University-at-Buffalo-SEDS/Flight-Computer-PCB/orders/Digikey 2019-11-08.xlsx

Mfg | Mfg PN | Digikey PN | Description | Qty | Unit Price | Subtotal
STMicroelectronics | STM32F303RET6 | 497-15163-ND | ARM® Cortex®-M4 STM32F3 Microcontroller IC 32-Bit 72MHz 512KB (512K x 8) FLASH 64-LQFP (10x10) | 4 | $7.19 | $28.76
Diodes Incorporated | DMN3023L-7 | DMN3023L-7DICT-ND | N-Channel 30V 6.2A (Ta) 900mW (Ta) Surface Mount SOT-23 | 10 | $0.30 | $2.98
Diodes Incorporated | DMP3099L-7 | DMP3099L-7DICT-ND | P-Channel 30V 3.8A (Ta) 1.08W (Ta) Surface Mount SOT-23 | 10 | $0.25 | $2.50
ON Semiconductor | BSS138 | BSS138CT-ND | N-Channel 50V 220mA (Ta) 360mW (Ta) Surface Mount SOT-23-3 | 10 | $0.22 | $2.20
ON Semiconductor | BSS84 | BSS84CT-ND | P-Channel 50V 130mA (Ta) 360mW (Ta) Surface Mount SOT-23-3 | 10 | $0.28 | $2.80
Nexperia USA Inc. | BAT54S,215 | 1727-2904-1-ND | Diode Array 1 Pair Series Connection Schottky 30V 200mA (DC) Surface Mount TO-236-3, SC-59, SOT-23-3 | 20 | $0.20 | $3.96
Winbond Electronics | W25Q16JVSNIQ | W25Q16JVSNIQ-ND | FLASH - NOR Memory IC 16Mb (2M x 8) SPI - Quad I/O 133MHz 8-SOIC | 4 | $0.49 | $1.96
On Shore Technology Inc. | OSTVN08A150 | ED10566-ND | 8 Position Wire to Board Terminal Block Horizontal with Board 0.100" (2.54mm) Through Hole | 4 | $2.36 | $9.44
Samsung Electro-Mechanics | CL10B104KB8NNNC | 1276-1000-1-ND | 0.1µF ±10% 50V Ceramic Capacitor X7R 0603 (1608 Metric) | 100 | $0.01 | $1.18
Maxim Integrated | MAX7375AXR805+T | MAX7375AXR805+TCT-ND | 8MHz XO (Standard) CMOS Oscillator 2.7V ~ 5.5V SC-70, SOT-323 | 4 | $1.46 | $5.84
 |  |  |  |  | GT | $61.62
