University-at-Buffalo-SEDS/Flight-Computer-PCB/Flight Computer.kicad_pcb

## KiCad design Flight Computer.kicad_pcb (2020-02-22)

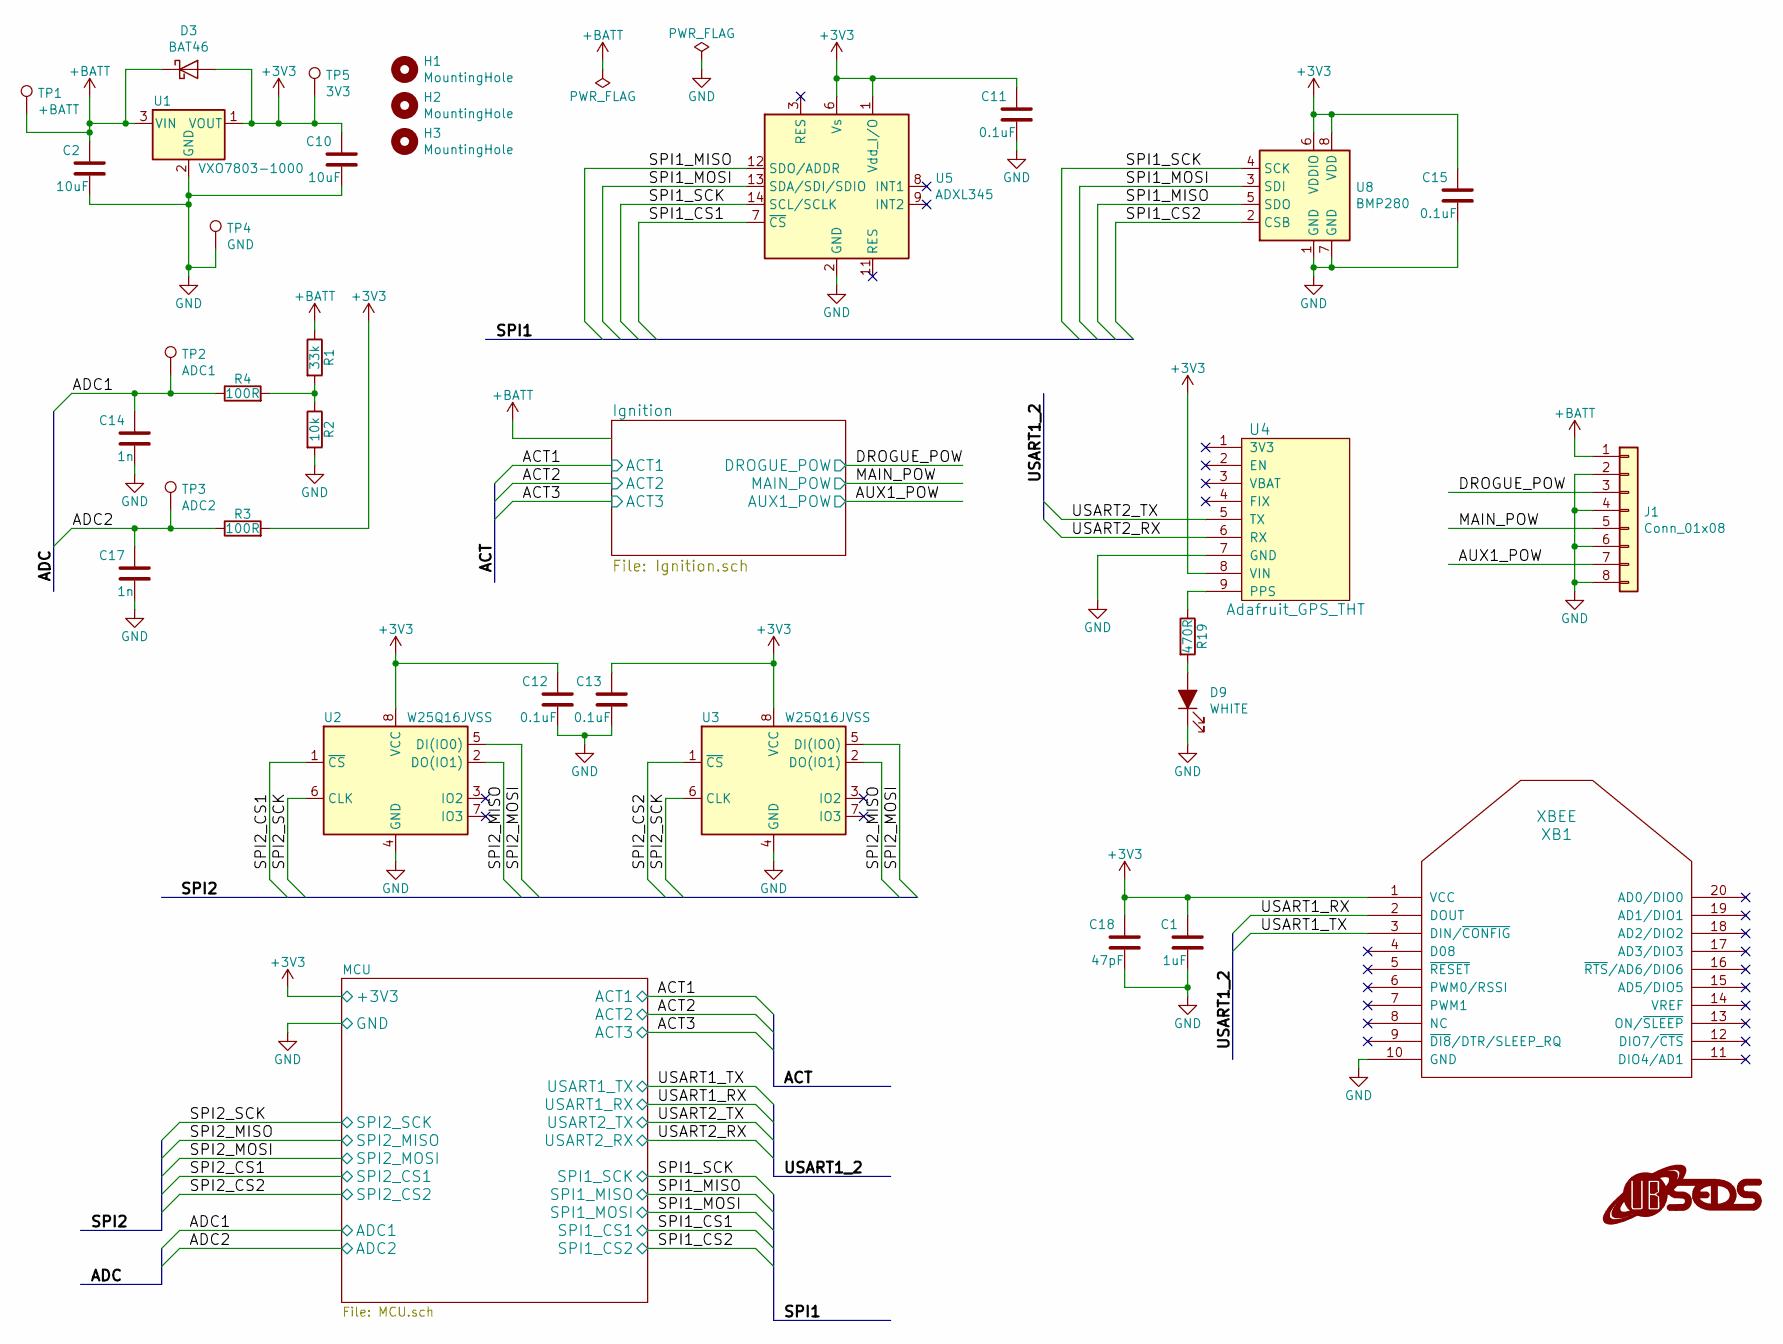
[picture p1: schematic Flight Computer.sch]

Parts:
C1: 1uF; C_0603_1608Metric_Pad1.05x0.95mm_HandSolder
C2, C10: 10uF; C_1206_3216Metric_Pad1.42x1.75mm_HandSolder
C11, C12, C13, C15: 0.1uF; C_0603_1608Metric_Pad1.05x0.95mm_HandSolder
C14, C17: 1n; C_0603_1608Metric_Pad1.05x0.95mm_HandSolder
C18: 47pF; C_0603_1608Metric_Pad1.05x0.95mm_HandSolder
D3: BAT46; D_SOD-123
D9: WHITE; LED_0603_1608Metric_Pad1.05x0.95mm_HandSolder
G1: LOGO; SEDS_logo_soldermask
H1, H2, H3: MountingHole; MountingHole_2.5mm
J1: Conn_01x08; PinHeader_1x08_P2.54mm_Vertical
R1: 33k; R_0603_1608Metric_Pad1.05x0.95mm_HandSolder
R2: 10k; R_0603_1608Metric_Pad1.05x0.95mm_HandSolder
R3, R4: 100R; R_0603_1608Metric_Pad1.05x0.95mm_HandSolder
R19: 470R; R_0603_1608Metric_Pad1.05x0.95mm_HandSolder
TP1: +BATT; TestPoint_Pad_D1.0mm
TP2: ADC1; TestPoint_Pad_D1.0mm
TP3: ADC2; TestPoint_Pad_D1.0mm
TP4: GND; TestPoint_Pad_D1.0mm
TP5: 3V3; TestPoint_Pad_D1.0mm
U1: VXO7803-1000
U2, U3: W25Q16JVSS; SOIC-8_5.23x5.23mm_P1.27mm
U4: Adafruit_GPS_THT
U5: ADXL345; CC-14-1
U8: BMP280; Bosch_LGA-8_2x2.5mm_P0.65mm_ClockwisePinNumbering
XB1: XBEE; XBEE_PRO_PTH

Connections:
+3V3: C1.2, C10.2, C11.2, C12.2, C13.2, C15.2, C18.2, D3.2 (A), R3.2, TP5.1, U1.1 (VOUT), U2.8 (VCC), U3.8 (VCC), U4.8 (VIN), U5.1 (Vdd_I/O), U5.6 (Vs), U8.6 (VDDIO), U8.8 (VDD), XB1.1 (VCC); also elsewhere on the board
+BATT: C2.2, D3.1 (K), J1.1, R1.1, TP1.1, U1.3 (VIN); also elsewhere on the board
/ADC1: C14.2, R4.1, TP2.1; also elsewhere on the board
/ADC2: C17.2, R3.1, TP3.1; also elsewhere on the board
/AUX1_POW: J1.7; also elsewhere on the board
/DROGUE_POW: J1.3; also elsewhere on the board
/MAIN_POW: J1.5; also elsewhere on the board
/SPI1_CS1: U5.7 (~CS); also elsewhere on the board
/SPI1_CS2: U8.2 (CSB); also elsewhere on the board
/SPI1_MISO: U5.12 (SDO/ADDR), U8.5 (SDO); also elsewhere on the board
/SPI1_MOSI: U5.13 (SDA/SDI/SDIO), U8.3 (SDI); also elsewhere on the board
/SPI1_SCK: U5.14 (SCL/SCLK), U8.4 (SCK); also elsewhere on the board
/SPI2_CS1: U2.1 (~CS); also elsewhere on the board
/SPI2_CS2: U3.1 (~CS); also elsewhere on the board
/SPI2_MISO: U2.2 (DO(IO1)), U3.2 (DO(IO1)); also elsewhere on the board
/SPI2_MOSI: U2.5 (DI(IO0)), U3.5 (DI(IO0)); also elsewhere on the board
/SPI2_SCK: U2.6 (CLK), U3.6 (CLK); also elsewhere on the board
/USART1_RX: XB1.2 (DOUT); also elsewhere on the board
/USART1_TX: XB1.3 (DIN/~CONFIG); also elsewhere on the board
/USART2_RX: U4.6 (RX); also elsewhere on the board
/USART2_TX: U4.5 (TX); also elsewhere on the board
GND: C1.1, C2.1, C10.1, C11.1, C12.1, C13.1, C14.1, C15.1, C17.1, C18.1, D9.1 (K), J1.2, J1.4, J1.6, J1.8, R2.2, TP4.1, U1.2 (GND), U2.4 (GND), U3.4 (GND), U4.7 (GND), U5.2 (GND), U5.4 (GND), U5.5 (GND), U8.1 (GND), U8.7 (GND), XB1.10 (GND); also elsewhere on the board
unnamed: D9.2 (A), R19.2
unnamed: R1.2, R2.1, R4.2
unnamed: R19.1, U4.9 (PPS)

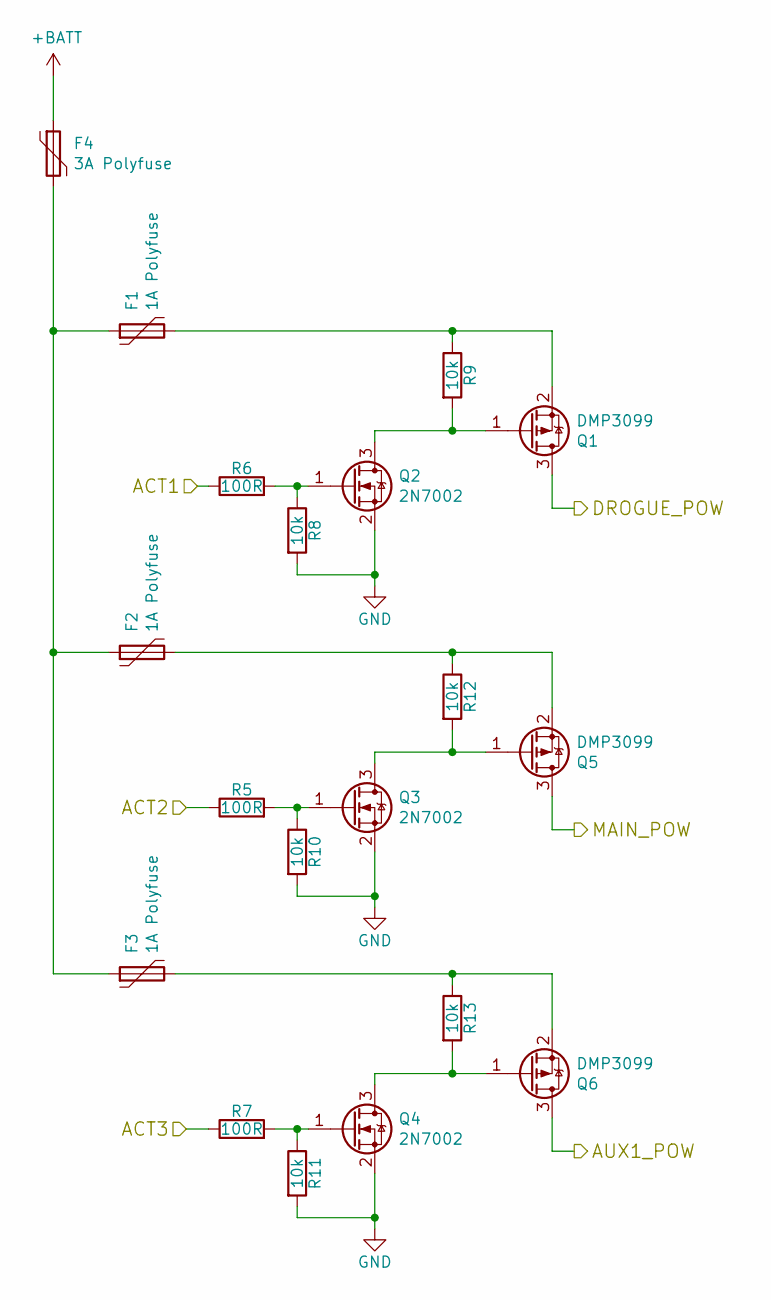
[picture p2: schematic Ignition.sch]

Parts:
F1, F2, F3: 1A Polyfuse; Fuse_1206_3216Metric_Pad1.42x1.75mm_HandSolder
F4: 3A Polyfuse; Fuse_1206_3216Metric_Pad1.42x1.75mm_HandSolder
Q1, Q5, Q6: DMP3099; SOT-23
Q2, Q3, Q4: 2N7002; SOT-23
R5, R6, R7: 100R; R_0603_1608Metric_Pad1.05x0.95mm_HandSolder
R8, R9, R10, R11, R12, R13: 10k; R_0603_1608Metric_Pad1.05x0.95mm_HandSolder

Connections:
+BATT: F4.1; also elsewhere on the board
/ACT1: R6.1; also elsewhere on the board
/ACT2: R5.1; also elsewhere on the board
/ACT3: R7.1; also elsewhere on the board
/AUX1_POW: Q6.3 (D); also elsewhere on the board
/DROGUE_POW: Q1.3 (D); also elsewhere on the board
/MAIN_POW: Q5.3 (D); also elsewhere on the board
GND: Q2.2 (S), Q3.2 (S), Q4.2 (S), R8.2, R10.2, R11.2; also elsewhere on the board
unnamed: F1.1, F2.1, F3.1, F4.2
unnamed: F1.2, Q1.2 (S), R9.1
unnamed: F2.2, Q5.2 (S), R12.1
unnamed: F3.2, Q6.2 (S), R13.1
unnamed: Q1.1 (G), Q2.3 (D), R9.2
unnamed: Q2.1 (G), R6.2, R8.1
unnamed: Q3.1 (G), R5.2, R10.1
unnamed: Q3.3 (D), Q5.1 (G), R12.2
unnamed: Q4.1 (G), R7.2, R11.1
unnamed: Q4.3 (D), Q6.1 (G), R13.2

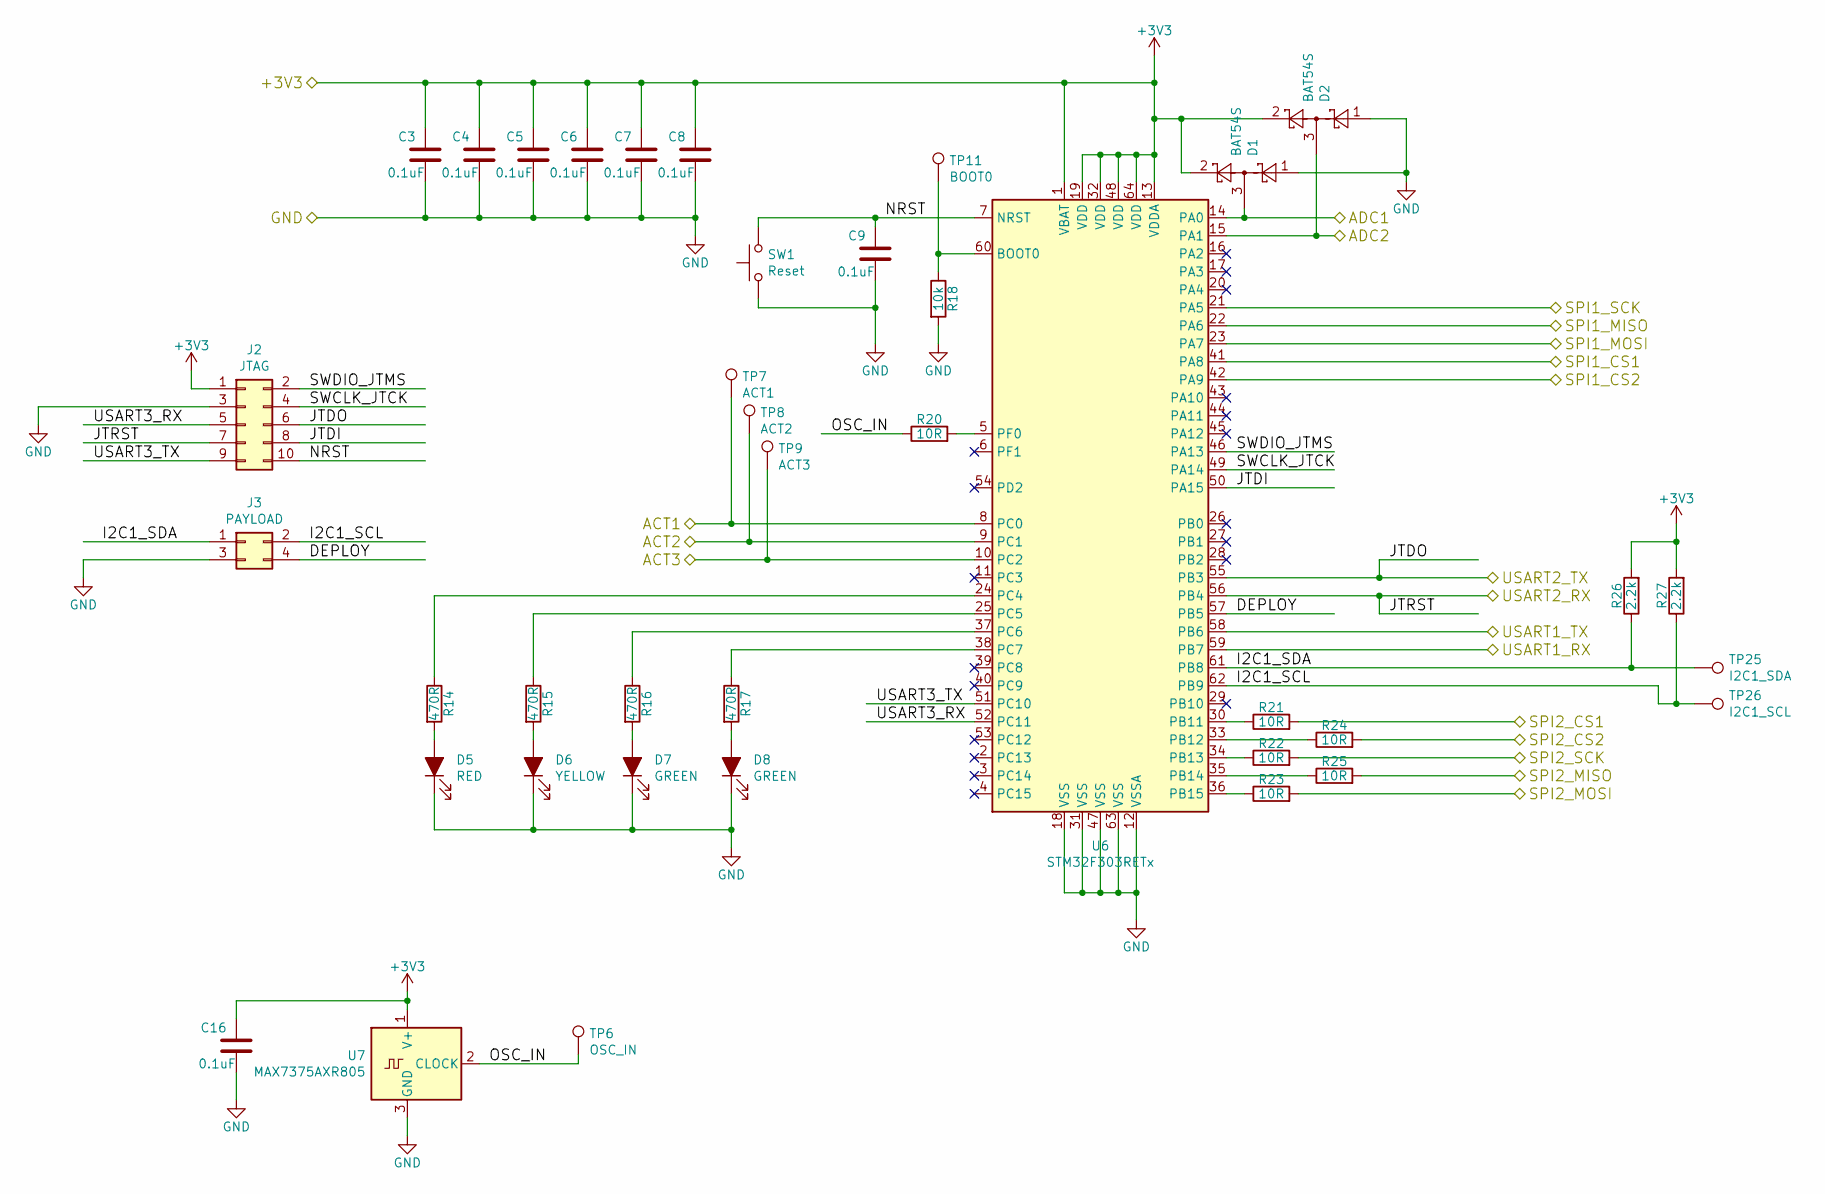
[picture p3: schematic MCU.sch, Flight Computer]

Parts:
C3, C4, C5, C6, C7, C8, C9, C16: 0.1uF; C_0603_1608Metric_Pad1.05x0.95mm_HandSolder
D1, D2: BAT54S; SOT-23
D5: RED; LED_0603_1608Metric_Pad1.05x0.95mm_HandSolder
D6: YELLOW; LED_0603_1608Metric_Pad1.05x0.95mm_HandSolder
D7, D8: GREEN; LED_0603_1608Metric_Pad1.05x0.95mm_HandSolder
J2: JTAG; PinHeader_2x05_P1.27mm_Vertical_SMD
J3: PAYLOAD; PinHeader_2x02_P1.27mm_Vertical
R14, R15, R16, R17: 470R; R_0603_1608Metric_Pad1.05x0.95mm_HandSolder
R18: 10k; R_0603_1608Metric_Pad1.05x0.95mm_HandSolder
R20, R21, R22, R23, R24, R25: 10R; R_0603_1608Metric_Pad1.05x0.95mm_HandSolder
R26, R27: 2.2k; R_0603_1608Metric_Pad1.05x0.95mm_HandSolder
SW1: Reset; SW_Push_1P1T_NO_CK_KMR2
TP6: OSC_IN; TestPoint_Pad_D1.0mm
TP7: ACT1; TestPoint_Pad_D1.0mm
TP8: ACT2; TestPoint_Pad_D1.0mm
TP9: ACT3; TestPoint_Pad_D1.0mm
TP11: BOOT0; TestPoint_Pad_D1.0mm
TP25: I2C1_SDA; TestPoint_Pad_D1.0mm
TP26: I2C1_SCL; TestPoint_Pad_D1.0mm
U6: STM32F303RETx; LQFP-64_10x10mm_P0.5mm
U7: MAX7375AXR805; SOT-323_SC-70

Connections:
+3V3: C3.2, C4.2, C5.2, C6.2, C7.2, C8.2, C16.2, D1.2, D2.2, J2.1, R26.2, R27.2, U6.1 (VBAT), U6.13 (VDDA), U6.19 (VDD), U6.32 (VDD), U6.48 (VDD), U6.64 (VDD), U7.1 (V+); also elsewhere on the board
/ACT1: TP7.1, U6.8 (PC0); also elsewhere on the board
/ACT2: TP8.1, U6.9 (PC1); also elsewhere on the board
/ACT3: TP9.1, U6.10 (PC2); also elsewhere on the board
/ADC1: D1.3, U6.14 (PA0); also elsewhere on the board
/ADC2: D2.3, U6.15 (PA1); also elsewhere on the board
/MCU/DEPLOY: J3.4, U6.57 (PB5)
/MCU/I2C1_SCL: J3.2, R27.1, TP26.1, U6.62 (PB9)
/MCU/I2C1_SDA: J3.1, R26.1, TP25.1, U6.61 (PB8)
/MCU/JTDI: J2.8, U6.50 (PA15)
/MCU/NRST: C9.2, J2.10, SW1.2, U6.7 (NRST)
/MCU/OSC_IN: R20.1, TP6.1, U7.2 (CLOCK)
/MCU/SWCLK_JTCK: J2.4, U6.49 (PA14)
/MCU/SWDIO_JTMS: J2.2, U6.46 (PA13)
/MCU/USART3_RX: J2.5, U6.52 (PC11)
/MCU/USART3_TX: J2.9, U6.51 (PC10)
/SPI1_CS1: U6.41 (PA8); also elsewhere on the board
/SPI1_CS2: U6.42 (PA9); also elsewhere on the board
/SPI1_MISO: U6.22 (PA6); also elsewhere on the board
/SPI1_MOSI: U6.23 (PA7); also elsewhere on the board
/SPI1_SCK: U6.21 (PA5); also elsewhere on the board
/SPI2_CS1: R21.2; also elsewhere on the board
/SPI2_CS2: R24.2; also elsewhere on the board
/SPI2_MISO: R25.2; also elsewhere on the board
/SPI2_MOSI: R23.2; also elsewhere on the board
/SPI2_SCK: R22.2; also elsewhere on the board
/USART1_RX: U6.59 (PB7); also elsewhere on the board
/USART1_TX: U6.58 (PB6); also elsewhere on the board
/USART2_RX: J2.7, U6.56 (PB4); also elsewhere on the board
/USART2_TX: J2.6, U6.55 (PB3); also elsewhere on the board
GND: C3.1, C4.1, C5.1, C6.1, C7.1, C8.1, C9.1, C16.1, D1.1, D2.1, D5.1 (K), D6.1 (K), D7.1 (K), D8.1 (K), J2.3, J3.3, R18.2, SW1.1, U6.12 (VSSA), U6.18 (VSS), U6.31 (VSS), U6.47 (VSS), U6.63 (VSS), U7.3 (GND); also elsewhere on the board
unnamed: D5.2 (A), R14.2
unnamed: D6.2 (A), R15.2
unnamed: D7.2 (A), R16.2
unnamed: D8.2 (A), R17.2
unnamed: R14.1, U6.24 (PC4)
unnamed: R15.1, U6.25 (PC5)
unnamed: R16.1, U6.37 (PC6)
unnamed: R17.1, U6.38 (PC7)
unnamed: R18.1, TP11.1, U6.60 (BOOT0)
unnamed: R20.2, U6.5 (PF0)
unnamed: R21.1, U6.30 (PB11)
unnamed: R22.1, U6.34 (PB13)
unnamed: R23.1, U6.36 (PB15)
unnamed: R24.1, U6.33 (PB12)
unnamed: R25.1, U6.35 (PB14)

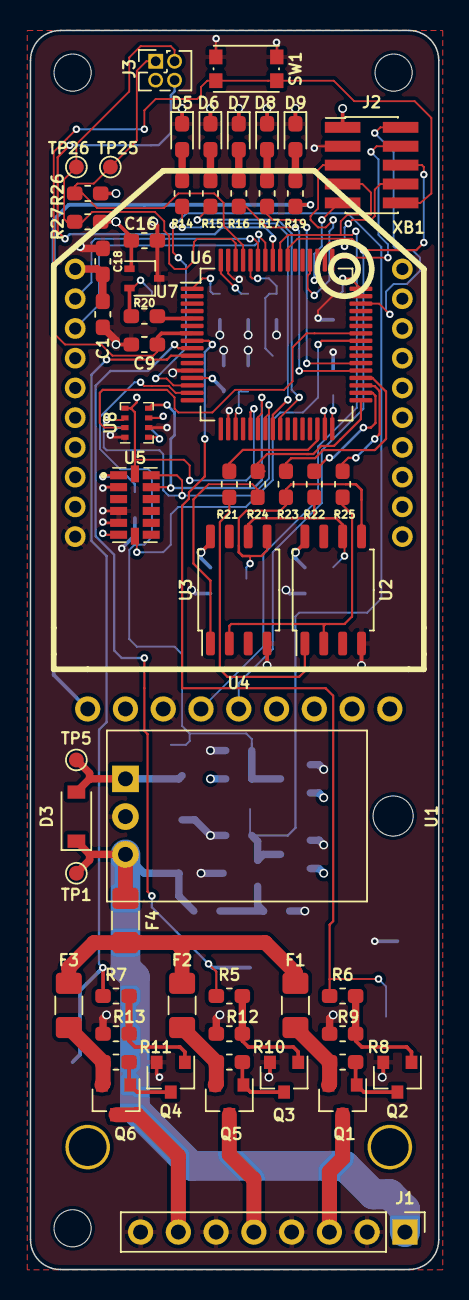
[picture p4: board Flight Computer.kicad_pcb from above]

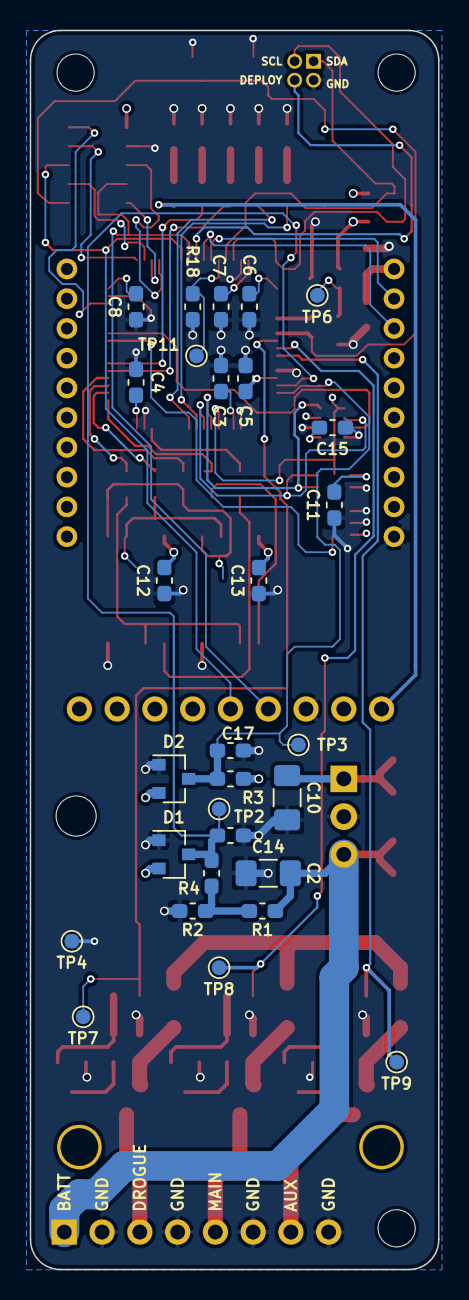
[picture p5: board Flight Computer.kicad_pcb from below]

Board: 4 copper layers, 27.5 x 83.3 mm, 92 parts (30 on the bottom side), 63 nets.
