University-at-Buffalo-SEDS/Flight-Computer-PCB/(commit log)

2019-12-11 New V2 integrated flight computer schematic Moved MCU to its own sheet Added datasheets Added KiCAD footprint submodule
    [Digikey 2019-11-08.xlsx, Flight Computer.sch, Ignition.sch, MCU.sch]
2019-12-13 Added JTAG and BOOT connectors to MCU Moved I2C1 pins
2019-12-13 Updated pinmap
    [Flight Computer.sch, MCU.sch]
2019-12-20 New pyro transistors New IO connector Changed SPI pins
    [Flight Computer.sch, Ignition.sch]
2019-12-24 Starting to fix ERC errors
    [Flight Computer.sch, Ignition.sch, MCU.sch]
2019-12-24 Fixed most ERC errors
    [Flight Computer.sch, MCU.sch]
2020-01-04 Removed redundant ADC protection diodes Basic PCB component layout
    [Flight Computer.kicad_pcb, Flight Computer.sch, Ignition.sch, MCU.sch]
2020-01-07 Renamed some components?
    [Flight Computer.sch, Ignition.sch, MCU.sch]
2020-01-13 Fixed .gitmodules (host-agnostic) Added bypass caps Added NMOS to ignition sheet Added current-limiting resistors Fixed 3V3 ADC input
    [Flight Computer.kicad_pcb, Flight Computer.sch, Ignition.sch, MCU.sch]
2020-01-13 Add external oscillator Add BOOT0 pulldown Remove NRST external pullup Add test LEDs Smaller JTAG connector
    [Ignition.sch, MCU.sch]
2020-01-13 Annotated schematic Added 2N7002 packages Updated PCB
    [Flight Computer.kicad_pcb, Flight Computer.sch, Ignition.sch, MCU.sch]
2020-01-13 All ERC errors gone
    [Flight Computer.sch, MCU.sch]
2020-01-13 GPS module power fixed
    [Flight Computer.sch]
2020-01-13 Annotated schematic
    [Flight Computer.sch]
2020-01-13 Updated pinmap Added USART3 for external communication
    [Flight Computer.sch, MCU.sch]
2020-01-14 Cleaned up libraries Changed ADXL345 footprint
    [Flight Computer.sch, Ignition.sch, MCU.sch]
2020-01-14 Adding test points
    [Flight Computer.sch, MCU.sch]
2020-01-14 Finished adding test points Schematic annotated
    [Flight Computer.kicad_pcb, Flight Computer.sch, MCU.sch]
2020-01-17 Added 10R series termination resistors to high-speed digital lines Added reverse-power protection diode Added ADC filter capacitors Added I2C pullups Added individual polyfuses to pyro drivers Change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
    [Flight Computer.sch, Ignition.sch, MCU.sch]
2020-01-19 Preliminary component placement
    [Flight Computer.kicad_pcb]
2020-01-21 Much more compact component placement Some routing done
    [Flight Computer.kicad_pcb]
2020-01-29 Routing complete Removed some test points (couldn't easily place)
    [Flight Computer.kicad_pcb, Ignition.sch, MCU.sch]
2020-02-04 Fixed silk Fixed JTAG Added PAYLOAD connector with I2C
    [Flight Computer.kicad_pcb, Flight Computer.sch, MCU.sch]
2020-02-05 Add pin labels to silkscreen
    [Flight Computer.kicad_pcb]
2020-02-22 Increase clearance of trace to BOOT0 pin
    [Flight Computer.kicad_pcb]
